PinwheelerIntern-1/SmartCar/Audio/AudioTable.docx

Sl.No. | Audio File Name | Text | Duration miiliseconds
1 | 001.mp3 | Move Aside ,please give me side.
2 | 002 | Battery Low, Please Charge
3 | 003 | Hello, How are you doing today.
4 | 004 | Car is going Forward
5 | 005 | Car is going Reverse
6 | 006 | Car is turning Left
7 | 007 | Car is turning Right
8 | 008 | Car is spinning left
9 | 009 | Car is spinning Right
10 | 010 | Welcome to the future | 2000
11 | 011 | Network Connected
12 | 012 | Network Disconnected
13 | 013 | Music-Jingle
14 | 014 | Music-Caravan
15 | 015 | Have You quit Smoking
16 | 016 | I know you are a bit tired! Let’s take a ride on electric bicycle.
17 | 017 | Welcome Mr. Albert Einstein and More…
18 | 018 | Have you quit Smoking and more…
19 | 019 | Please try this virtual reality goggles.
20 | 020 | Welcome Mr Albert Einstein , I know your past future anmd present. I even know your quirky habits.
21 | 021 | Battery Low- Female Adult
22 | 022 | Hi There ! How are you doing today –Female Adult Voice
23 | 023 | Take Your Order
24 | 024 | `Going To Bar
25 | 025 | Going To KItchen
26 | 026 | WiFi Connected
27 | 027 | Connecting To WiFi
28 | 028 | Please Move Aside
29 | 029 | Would You like to wear a powersuit ?
30 | 030 | You can use our bio-toilets.
31 | 031 | You might be hungry by now ? Let’s try something from Air-Fryer.
