PinwheelerIntern-1/SmartCar/Audio/WhatsApp Image 2021-11-11 at 7.47.23 AM.jpeg

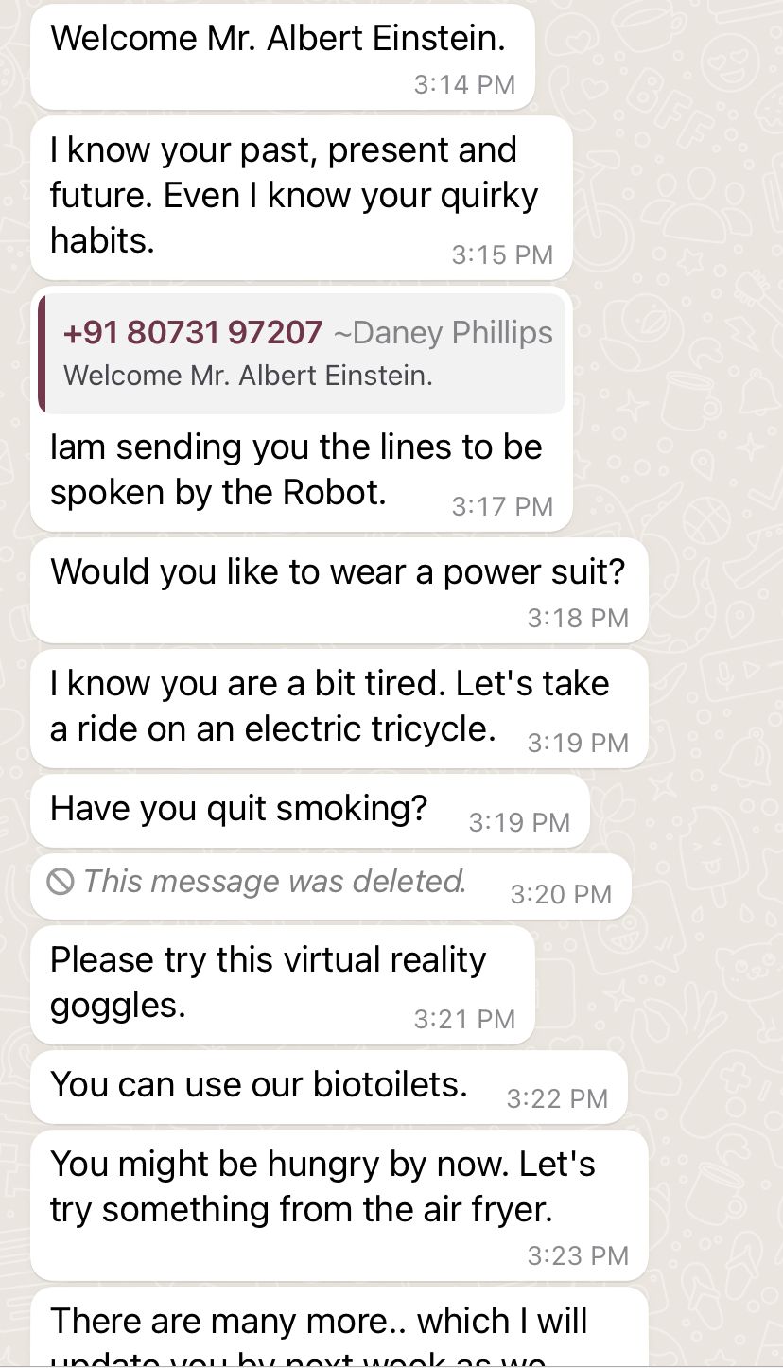
Audio/WhatsApp Image 2021-11-11 at 7.47.23 AM.jpeg
