PinwheelerIntern-1/SmartCar/PCBs/DIY-LM2596-Adjustable-Voltage-Swithching-Regulator.png

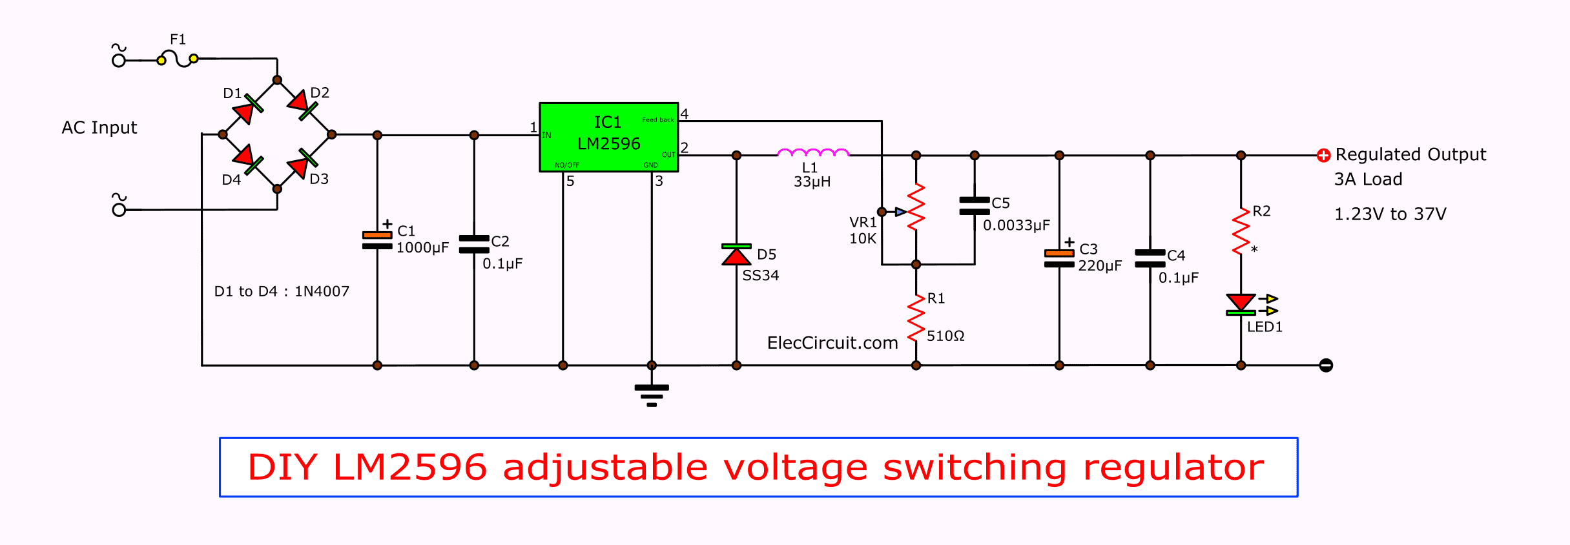
PCBs/DIY-LM2596-Adjustable-Voltage-Swithching-Regulator.png
