PinwheelerIntern-1/SmartCar/PCBs/5Obstacle.pdf

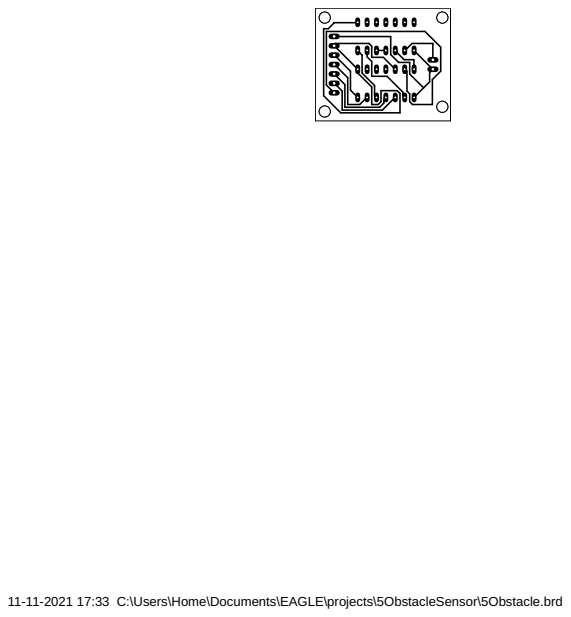
[picture p3: page 1]

11-11-2021 17:33 C:\Users\Home\Documents\EAGLE\projects\5ObstacleSensor\5Obstacle.brd
