PinwheelerIntern-1/SmartCar/PCBs/FutureBotNanoShield.brd

## EAGLE design PCBs/FutureBotNanoShield.brd (2021-12-03)

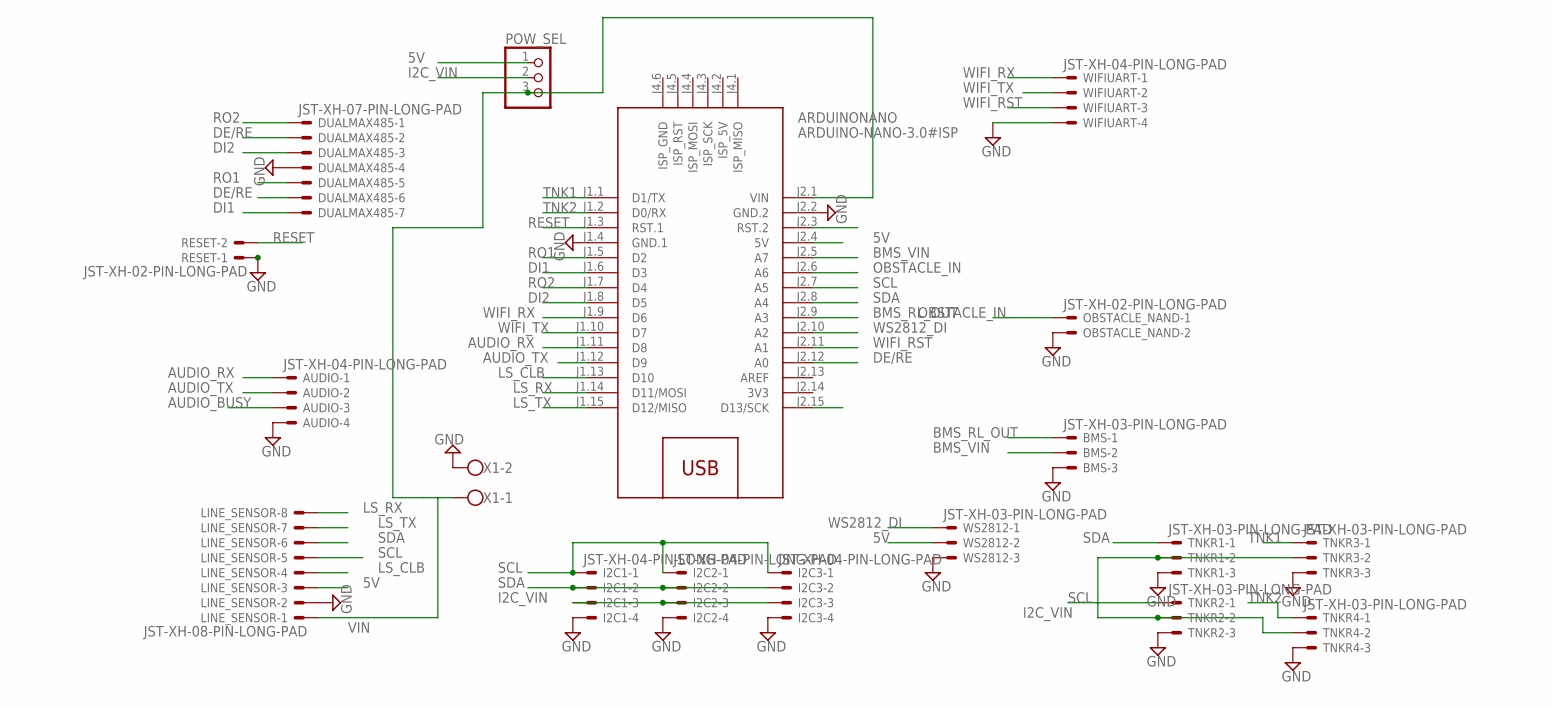
[picture p4: schematic FutureBotNanoShield.sch]

Parts:
ARDUINONANO: ARDUINO-NANO-3.0#ISP
AUDIO: JST-XH-04-PIN-LONG-PAD; JST-XH-04-PACKAGE-LONG-PAD
BMS: JST-XH-03-PIN-LONG-PAD; JST-XH-03-PACKAGE-LONG-PAD
DUALMAX485: JST-XH-07-PIN-LONG-PAD; JST-XH-07-PACKAGE-LONG-PAD
I2C1, I2C2, I2C3: JST-XH-04-PIN-LONG-PAD; JST-XH-04-PACKAGE-LONG-PAD
LINE_SENSOR: JST-XH-08-PIN-LONG-PAD; JST-XH-08-PACKAGE-LONG-PAD
OBSTACLE_NAND: JST-XH-02-PIN-LONG-PAD; JST-XH-02-PACKAGE-LONG-PAD
POW_SEL: PINHD-1X3; 1X03
RESET: JST-XH-02-PIN-LONG-PAD; JST-XH-02-PACKAGE-LONG-PAD
TNKR1, TNKR2, TNKR3, TNKR4: JST-XH-03-PIN-LONG-PAD; JST-XH-03-PACKAGE-LONG-PAD
WIFIUART: JST-XH-04-PIN-LONG-PAD; JST-XH-04-PACKAGE-LONG-PAD
WS2812: JST-XH-03-PIN-LONG-PAD; JST-XH-03-PACKAGE-LONG-PAD
X1: W237-102

Connections:
3V3: ARDUINONANO.J2.14 (3V3)
5V: ARDUINONANO.J2.4 (5V), LINE_SENSOR.3, POW_SEL.1, WS2812.2
AUDIO_BUSY: AUDIO.3
AUDIO_RX: ARDUINONANO.J1.11 (D8), AUDIO.1
AUDIO_TX: ARDUINONANO.J1.12 (D9), AUDIO.2
BMS_RL_OUT: ARDUINONANO.J2.9 (A3), BMS.1
BMS_VIN: ARDUINONANO.J2.5 (A7), BMS.2
DE/RE: ARDUINONANO.J2.12 (A0), DUALMAX485.2, DUALMAX485.6
DI1: ARDUINONANO.J1.6 (D3), DUALMAX485.7
DI2: ARDUINONANO.J1.8 (D5), DUALMAX485.3
GND: ARDUINONANO.J1.4 (GND.1), ARDUINONANO.J2.2 (GND.2), AUDIO.4, BMS.3, DUALMAX485.4, I2C1.4, I2C2.4, I2C3.4, LINE_SENSOR.2, OBSTACLE_NAND.2, RESET.1, TNKR1.3, TNKR2.3, TNKR3.3, TNKR4.3, WIFIUART.4, WS2812.3, X1.2
I2C_VIN: I2C1.3, I2C2.3, I2C3.3, POW_SEL.2, TNKR1.2, TNKR2.2, TNKR3.2, TNKR4.2
LS_CLB: ARDUINONANO.J1.13 (D10), LINE_SENSOR.4
LS_RX: ARDUINONANO.J1.14 (D11/MOSI), LINE_SENSOR.8
LS_TX: ARDUINONANO.J1.15 (D12/MISO), LINE_SENSOR.7
OBSTACLE_IN: ARDUINONANO.J2.6 (A6), OBSTACLE_NAND.1
RESET: ARDUINONANO.J1.3 (RST.1), RESET.2
RO1: ARDUINONANO.J1.5 (D2), DUALMAX485.5
RO2: ARDUINONANO.J1.7 (D4), DUALMAX485.1
SCL: ARDUINONANO.J2.7 (A5), I2C1.1, I2C2.1, I2C3.1, LINE_SENSOR.5, TNKR2.1
SDA: ARDUINONANO.J2.8 (A4), I2C1.2, I2C2.2, I2C3.2, LINE_SENSOR.6, TNKR1.1
TNK1: ARDUINONANO.J1.1 (D1/TX), TNKR3.1
TNK2: ARDUINONANO.J1.2 (D0/RX), TNKR4.1
VIN: ARDUINONANO.J2.1 (VIN), LINE_SENSOR.1, POW_SEL.3, X1.1
WIFI_RST: ARDUINONANO.J2.11 (A1), WIFIUART.3
WIFI_RX: ARDUINONANO.J1.9 (D6), WIFIUART.1
WIFI_TX: ARDUINONANO.J1.10 (D7), WIFIUART.2
WS2812_DI: ARDUINONANO.J2.10 (A2), WS2812.1

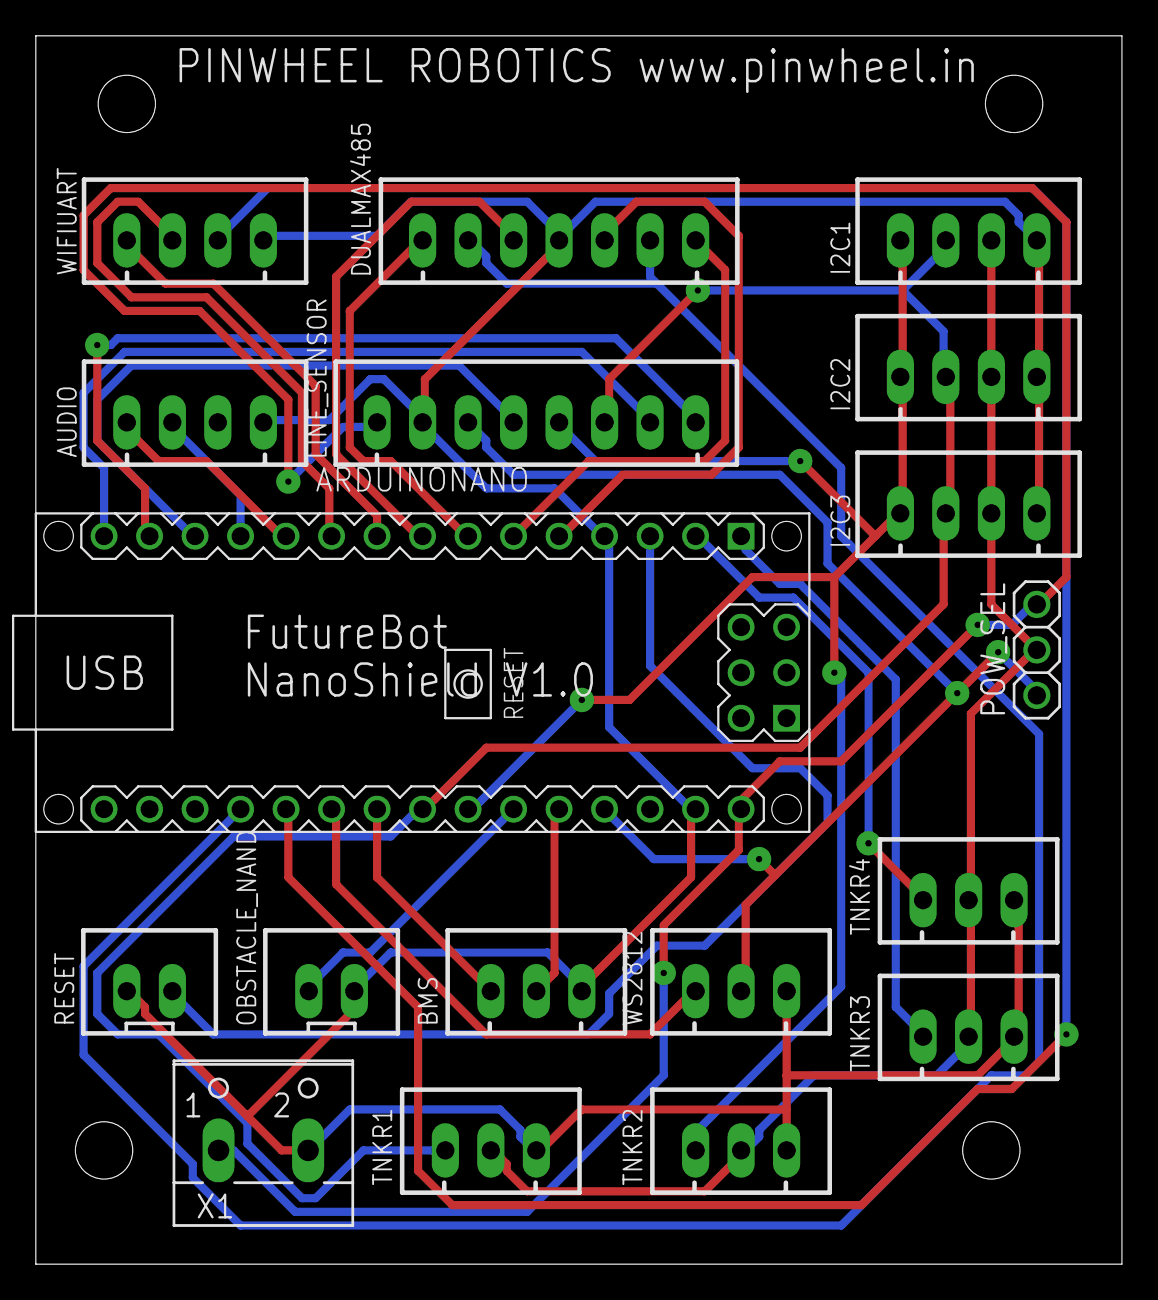
[picture p5: board FutureBotNanoShield.brd from above]

Board: 2 copper layers, 60.6 x 68.6 mm, 18 parts (0 on the bottom side), 26 nets.
