PinwheelerIntern-1/SmartCar/PCBs/5ObstacleNAND.brd

## EAGLE design PCBs/5ObstacleNAND.brd (2021-12-01)

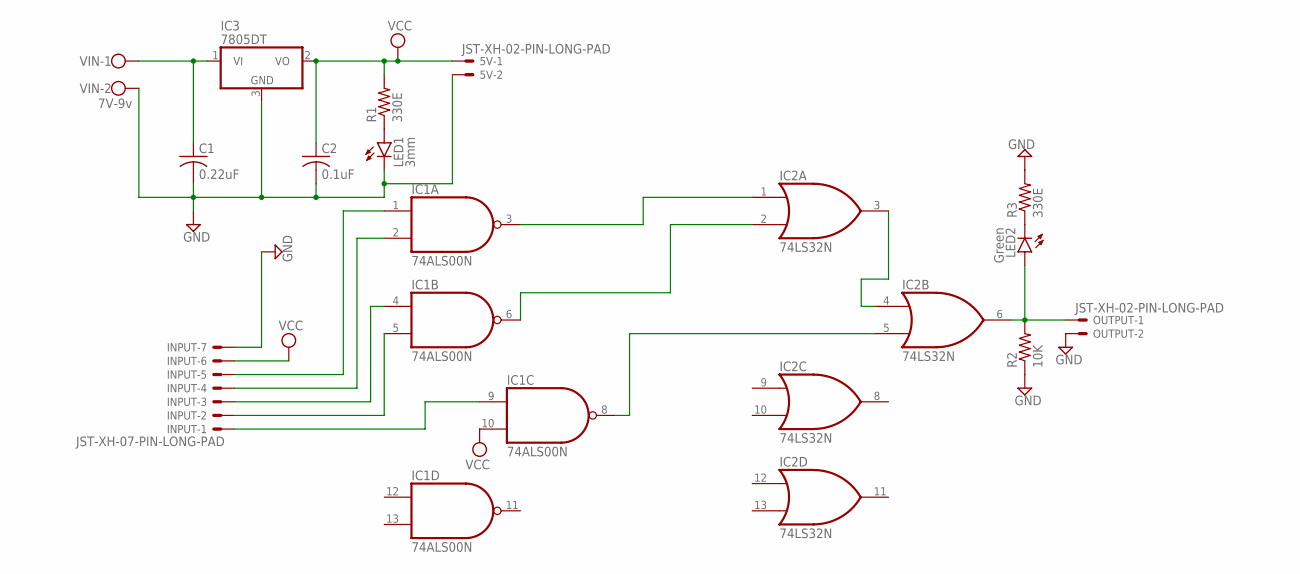
[picture p6: schematic 5ObstacleNAND.sch]

Parts:
5V: JST-XH-02-PIN-LONG-PAD; JST-XH-02-PACKAGE-LONG-PAD
C1: 0.22uF; C0805
C2: 0.1uF; C0805
IC1: 74ALS00N; DIL14
IC2: 74LS32N; DIL14
IC3: 7805DT; TO252
INPUT: JST-XH-07-PIN-LONG-PAD; JST-XH-07-PACKAGE-LONG-PAD
LED1: 3mm; SML0805
LED2: Green; SML0805
OUTPUT: JST-XH-02-PIN-LONG-PAD; JST-XH-02-PACKAGE-LONG-PAD
R1, R3: 330E; R0805
R2: 10K; R0805
VIN: 7V-9v; W237-102

Connections:
GND: 5V.2, C1.2, C2.2, IC1.7 (GND), IC2.7 (GND), IC3.3 (GND), INPUT.7, LED1.C, OUTPUT.2, R2.1, R3.2, VIN.2
unnamed: IC1.1 (I0), INPUT.5
unnamed: IC1.2 (I1), INPUT.4
unnamed: IC1.4 (I0), INPUT.3
unnamed: IC1.5 (I1), INPUT.2
unnamed: IC1.9 (I0), INPUT.1
unnamed: IC1.3 (O), IC2.1 (I0)
unnamed: IC1.6 (O), IC2.2 (I1)
unnamed: IC2.3 (O), IC2.4 (I0)
unnamed: IC1.8 (O), IC2.5 (I1)
unnamed: IC2.6 (O), LED2.A, OUTPUT.1, R2.2
unnamed: LED2.C, R3.1
unnamed: LED1.A, R1.1
unnamed: C1.1, IC3.1 (VI), VIN.1
VCC: 5V.1, C2.1, IC1.10 (I1), IC1.14 (VCC), IC2.14 (VCC), IC3.2 (VO), INPUT.6, R1.2

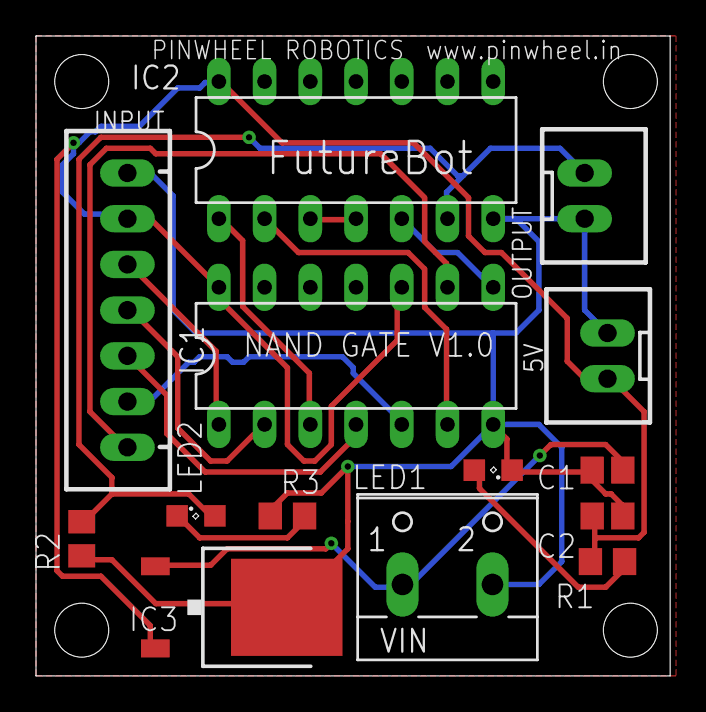
[picture p7: board 5ObstacleNAND.brd from above]

Board: 2 copper layers, 35.2 x 35.6 mm, 14 parts (0 on the bottom side), 15 nets.
