PinwheelerIntern-1/SmartCar/PCBs/DFPLayerAudio.brd

## EAGLE design PCBs/DFPLayerAudio.brd (2021-12-01)

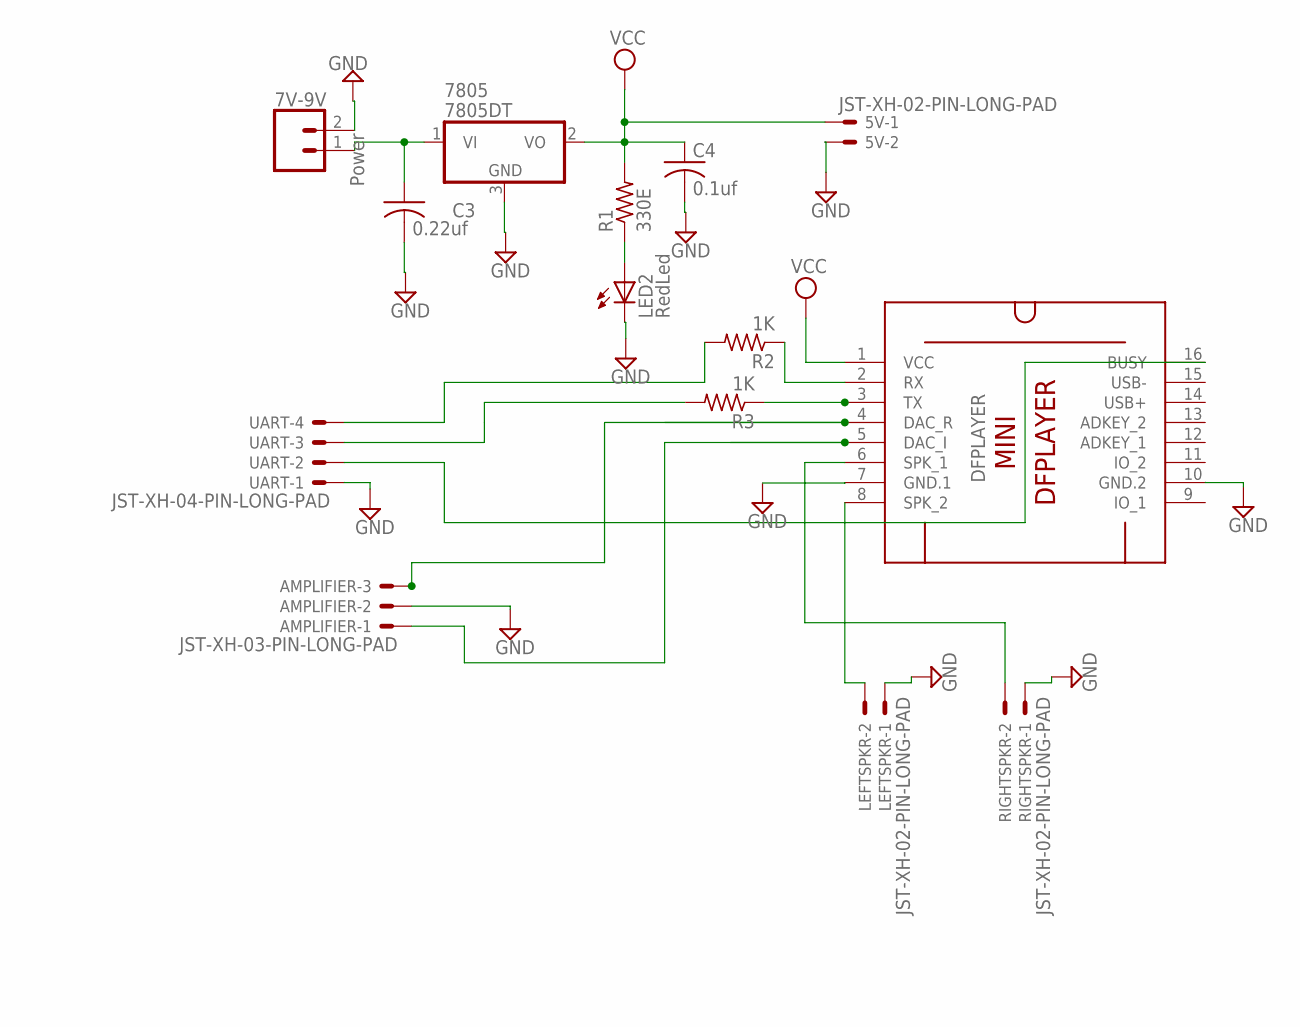
[picture p8: schematic DFPLayerAudio.sch]

Parts:
5V: JST-XH-02-PIN-LONG-PAD; JST-XH-02-PACKAGE-LONG-PAD
7V-9V: Power; SCREWTERMINAL-5MM-2
7805: 7805DT; TO252
AMPLIFIER: JST-XH-03-PIN-LONG-PAD; JST-XH-03-PACKAGE-LONG-PAD
C3: 0.22uf; C0805K
C4: 0.1uf; C0805K
DFPLAYER: DFPLAYER-MINI-MODULE
LED2: RedLed; CHIPLED_0805
LEFTSPKR: JST-XH-02-PIN-LONG-PAD; JST-XH-02-PACKAGE-LONG-PAD
R1: 330E; M0805
R2, R3: 1K; M0805
RIGHTSPKR: JST-XH-02-PIN-LONG-PAD; JST-XH-02-PACKAGE-LONG-PAD
UART: JST-XH-04-PIN-LONG-PAD; JST-XH-04-PACKAGE-LONG-PAD

Connections:
GND: 5V.2, 7V-9V.2, 7805.3 (GND), AMPLIFIER.2, C3.2, C4.2, DFPLAYER.7 (GND.1), DFPLAYER.10 (GND.2), LED2.C, LEFTSPKR.1, RIGHTSPKR.1, UART.1
unnamed: AMPLIFIER.3, DFPLAYER.4 (DAC_R)
unnamed: 7V-9V.1, 7805.1 (VI), C3.1
unnamed: DFPLAYER.3 (TX), R3.1
unnamed: DFPLAYER.2 (RX), R2.1
unnamed: DFPLAYER.16 (BUSY), UART.2
unnamed: R3.2, UART.3
unnamed: R2.2, UART.4
unnamed: DFPLAYER.8 (SPK_2), LEFTSPKR.2
unnamed: AMPLIFIER.1, DFPLAYER.5 (DAC_I)
unnamed: LED2.A, R1.1
unnamed: DFPLAYER.6 (SPK_1), RIGHTSPKR.2
VCC: 5V.1, 7805.2 (VO), C4.1, DFPLAYER.1 (VCC), R1.2

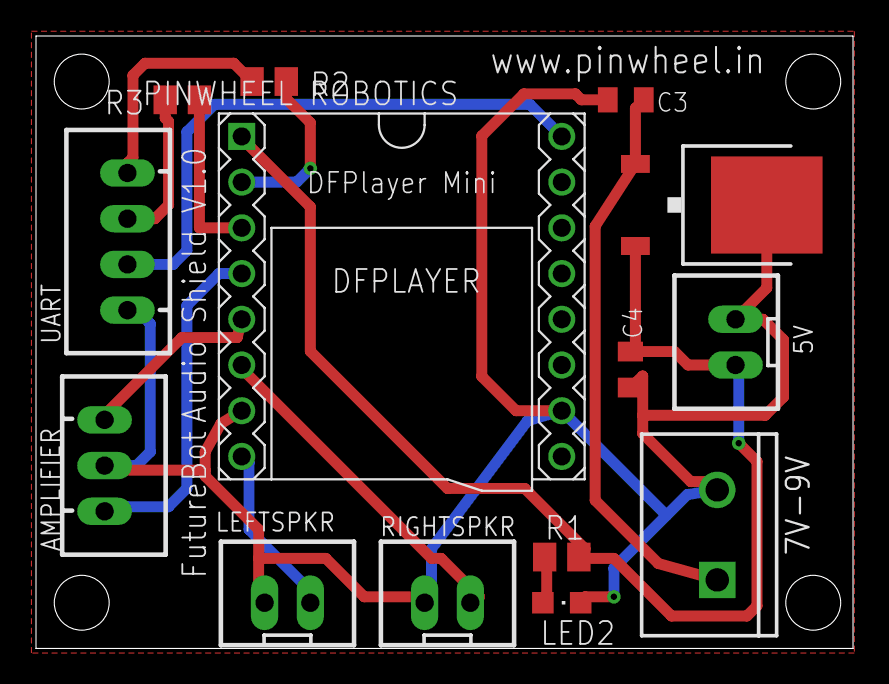
[picture p9: board DFPLayerAudio.brd from above]

Board: 2 copper layers, 45.4 x 34.0 mm, 14 parts (0 on the bottom side), 13 nets.
