PinwheelerIntern-1/SmartCar/PCBs/DualMax485.brd

## EAGLE design PCBs/DualMax485.brd (2021-12-01)

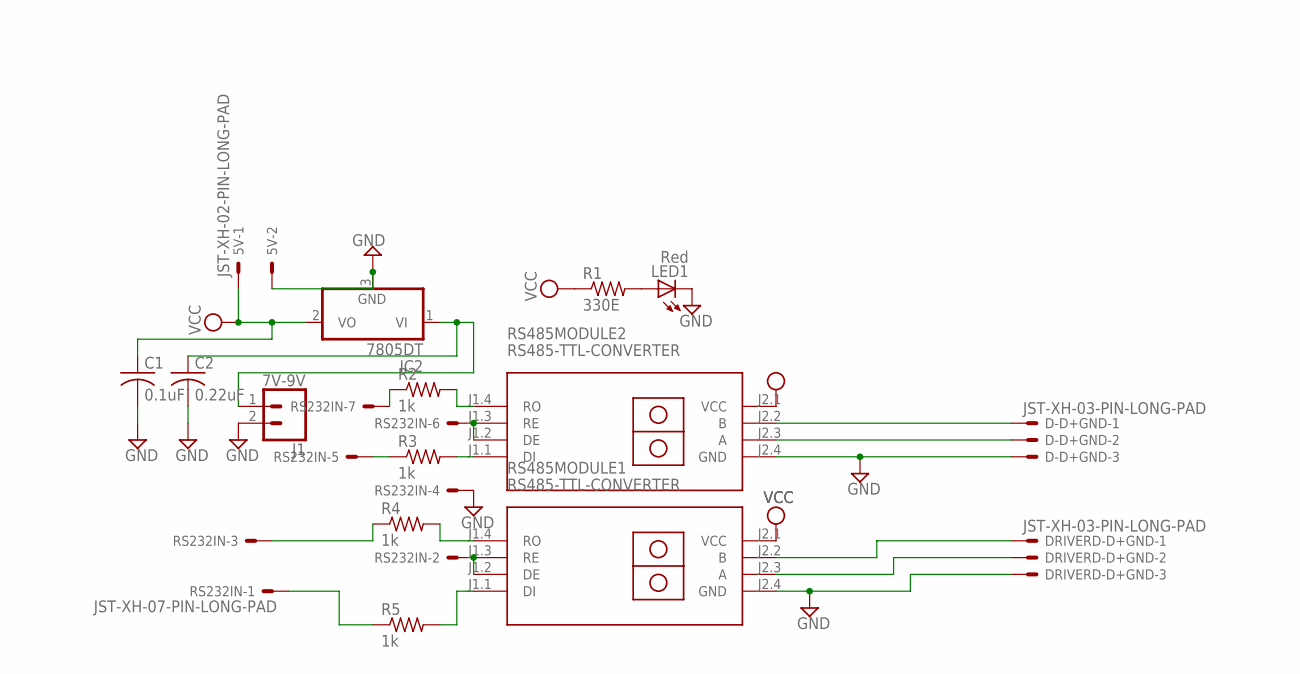
[picture p10: schematic DualMax485.sch]

Parts:
5V: JST-XH-02-PIN-LONG-PAD; JST-XH-02-PACKAGE-LONG-PAD
C1: 0.1uF; C0805
C2: 0.22uF; C0805
D-D+GND: JST-XH-03-PIN-LONG-PAD; JST-XH-03-PACKAGE-LONG-PAD
DRIVERD-D+GND: JST-XH-03-PIN-LONG-PAD; JST-XH-03-PACKAGE-LONG-PAD
IC2: 7805DT; TO252
J1: 7V-9V; SCREWTERMINAL-5MM-2
LED1: Red; CHIPLED_0805
R1: 330E; M0805
R2, R3, R4, R5: 1k; M0805
RS232IN: JST-XH-07-PIN-LONG-PAD; JST-XH-07-PACKAGE-LONG-PAD
RS485MODULE1, RS485MODULE2: RS485-TTL-CONVERTER

Connections:
GND: 5V.2, C1.2, C2.2, D-D+GND.3, DRIVERD-D+GND.3, IC2.3 (GND), J1.2, LED1.C, RS232IN.4, RS485MODULE1.J2.4 (GND), RS485MODULE2.J2.4 (GND)
unnamed: RS232IN.6, RS485MODULE2.J1.2 (DE), RS485MODULE2.J1.3 (RE)
unnamed: R3.2, RS485MODULE2.J1.1 (DI)
unnamed: R2.2, RS485MODULE2.J1.4 (RO)
unnamed: D-D+GND.1, RS485MODULE2.J2.2 (B)
unnamed: R3.1, RS232IN.5
unnamed: D-D+GND.2, RS485MODULE2.J2.3 (A)
unnamed: RS232IN.2, RS485MODULE1.J1.2 (DE), RS485MODULE1.J1.3 (RE)
unnamed: R5.1, RS232IN.1
unnamed: LED1.A, R1.2
unnamed: R4.1, RS232IN.3
unnamed: R2.1, RS232IN.7
unnamed: DRIVERD-D+GND.1, RS485MODULE1.J2.2 (B)
unnamed: DRIVERD-D+GND.2, RS485MODULE1.J2.3 (A)
unnamed: R4.2, RS485MODULE1.J1.4 (RO)
unnamed: R5.2, RS485MODULE1.J1.1 (DI)
unnamed: C2.1, IC2.1 (VI), J1.1
VCC: 5V.1, C1.1, IC2.2 (VO), R1.1, RS485MODULE1.J2.1 (VCC), RS485MODULE2.J2.1 (VCC)

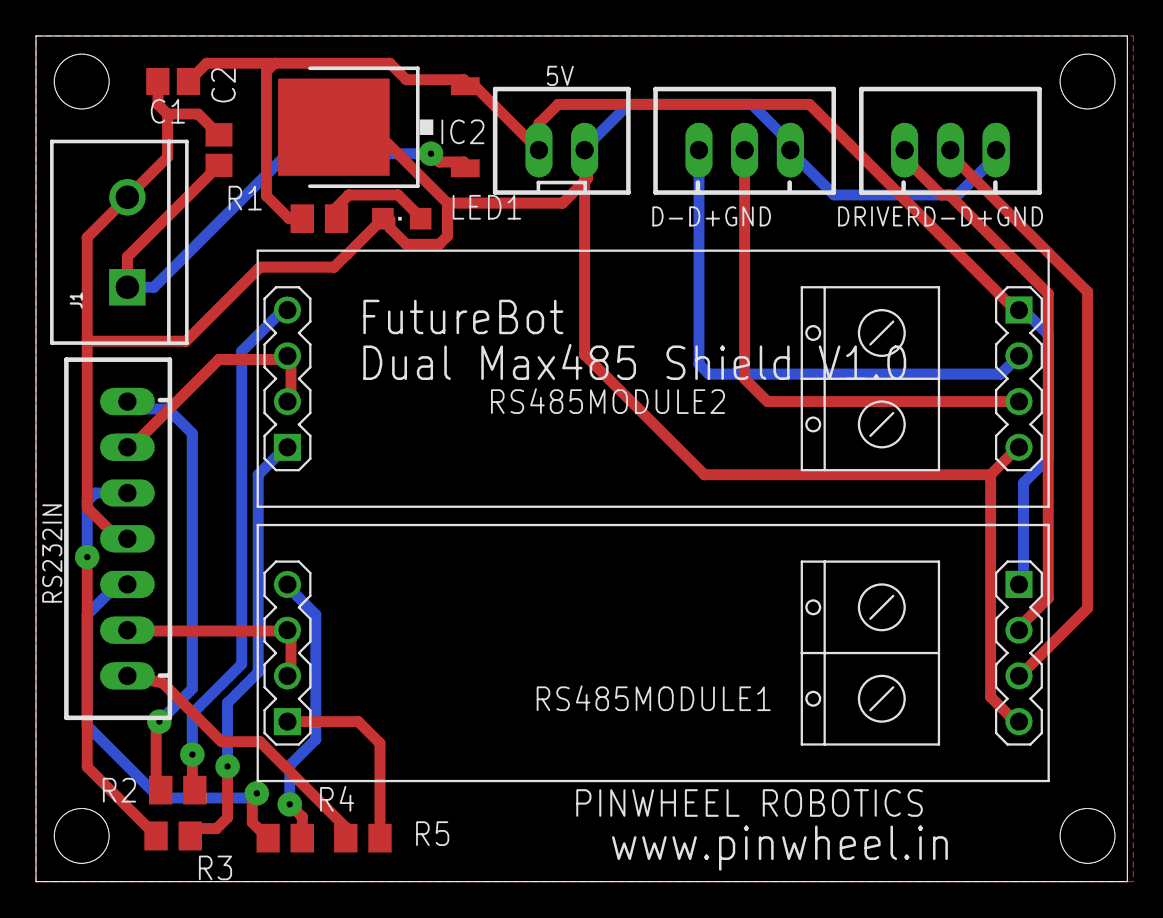
[picture p11: board DualMax485.brd from above]

Board: 2 copper layers, 60.6 x 47.0 mm, 16 parts (0 on the bottom side), 18 nets.
