PinwheelerIntern-1/SmartCar/PCBs/NodeMCU.brd

## EAGLE design PCBs/NodeMCU.brd (2021-12-01)

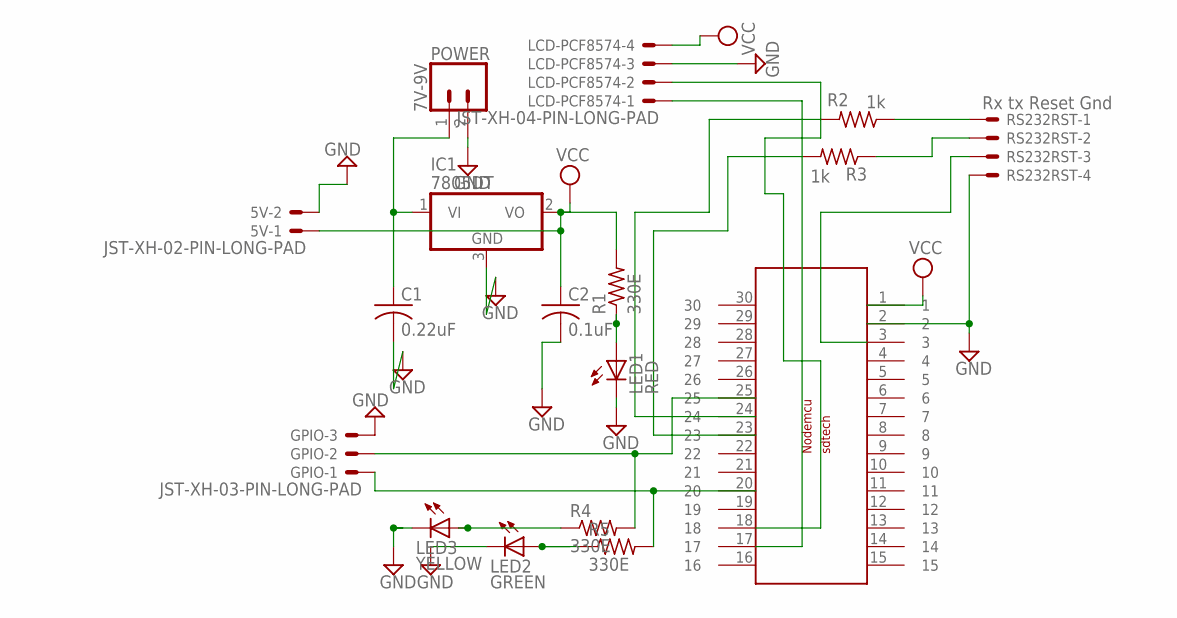
[picture p12: schematic NodeMCU.sch]

Parts:
5V: JST-XH-02-PIN-LONG-PAD; JST-XH-02-PACKAGE-LONG-PAD
C1: 0.22uF; C0805K
C2: 0.1uF; C0805K
GPIO: JST-XH-03-PIN-LONG-PAD; JST-XH-03-PACKAGE-LONG-PAD
IC1: 7805DT; TO252
LCD-PCF8574: JST-XH-04-PIN-LONG-PAD; JST-XH-04-PACKAGE-LONG-PAD
LED1: RED; CHIPLED_0805
LED2: GREEN; CHIPLED_0805
LED3: YELLOW; CHIPLED_0805
POWER: 7V-9V; SCREWTERMINAL-5MM-2
R1, R4, R5: 330E; M0805
R2, R3: 1k; M0805
RS232RST: Rx tx Reset Gnd; JST-XH-04-PACKAGE-LONG-PAD
U$2: NodeMCU-ESP12E; NODEMCUESP8266

Connections:
GND: 5V.2, C1.2, C2.2, GPIO.3, IC1.3 (GND), LCD-PCF8574.3, LED1.C, LED2.C, LED3.C, POWER.2, RS232RST.4, U$2.2
unnamed: LED1.A, R1.1
unnamed: LCD-PCF8574.2, U$2.18
unnamed: LED3.A, R4.1
unnamed: LED2.A, R5.1
unnamed: R2.1, RS232RST.1
unnamed: R2.2, U$2.24
unnamed: LCD-PCF8574.1, U$2.17
unnamed: R3.2, U$2.23
unnamed: C1.1, IC1.1 (VI), POWER.1
unnamed: R3.1, RS232RST.2
unnamed: RS232RST.3, U$2.3
unnamed: GPIO.2, R4.2, U$2.25
unnamed: GPIO.1, R5.2, U$2.20
VCC: 5V.1, C2.1, IC1.2 (VO), LCD-PCF8574.4, R1.2, U$2.1

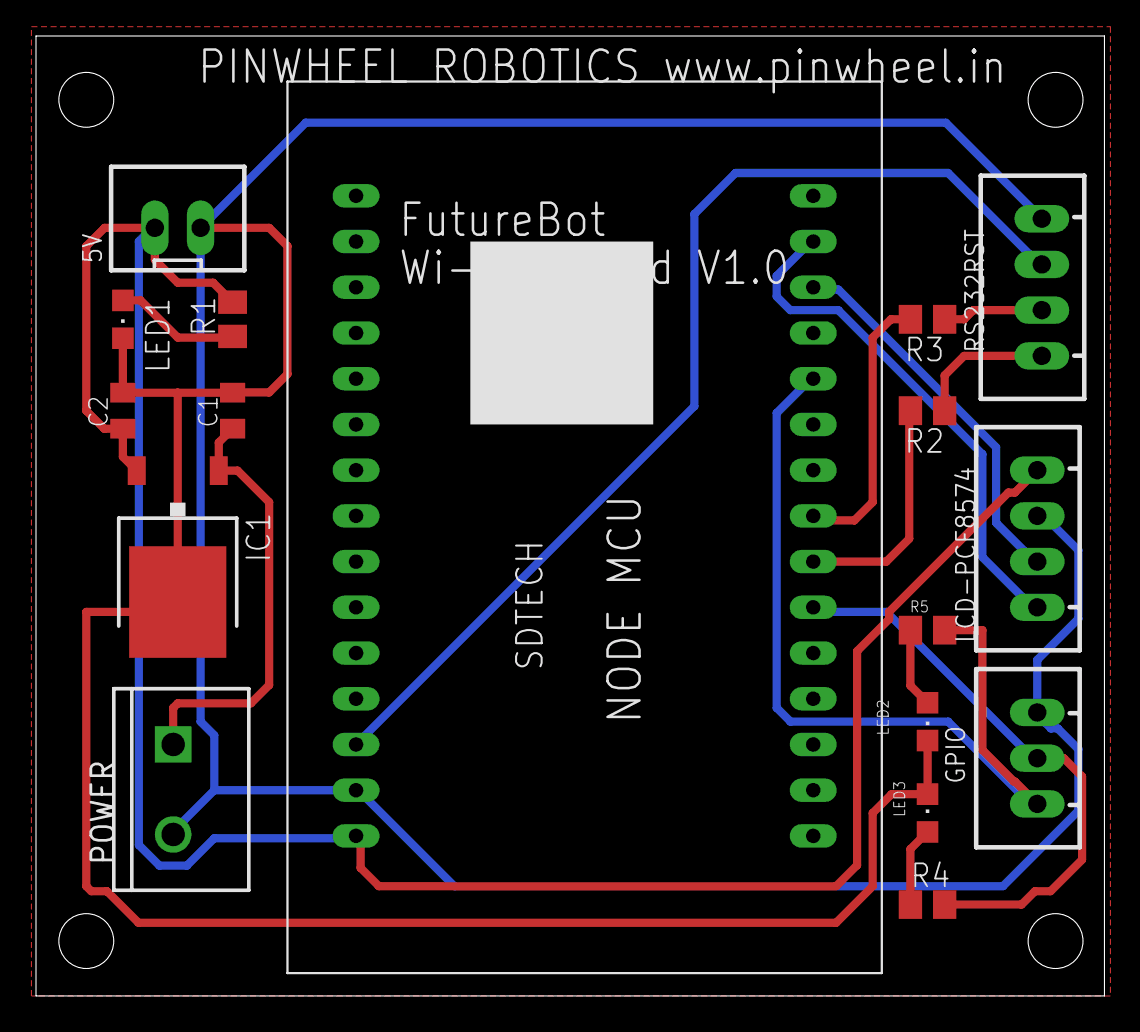
[picture p13: board NodeMCU.brd from above]

Board: 2 copper layers, 59.4 x 53.3 mm, 17 parts (0 on the bottom side), 15 nets.
