PinwheelerIntern-1/SmartCar/PCBs/BMSBoard.brd

## EAGLE design PCBs/BMSBoard.brd (2021-11-29)

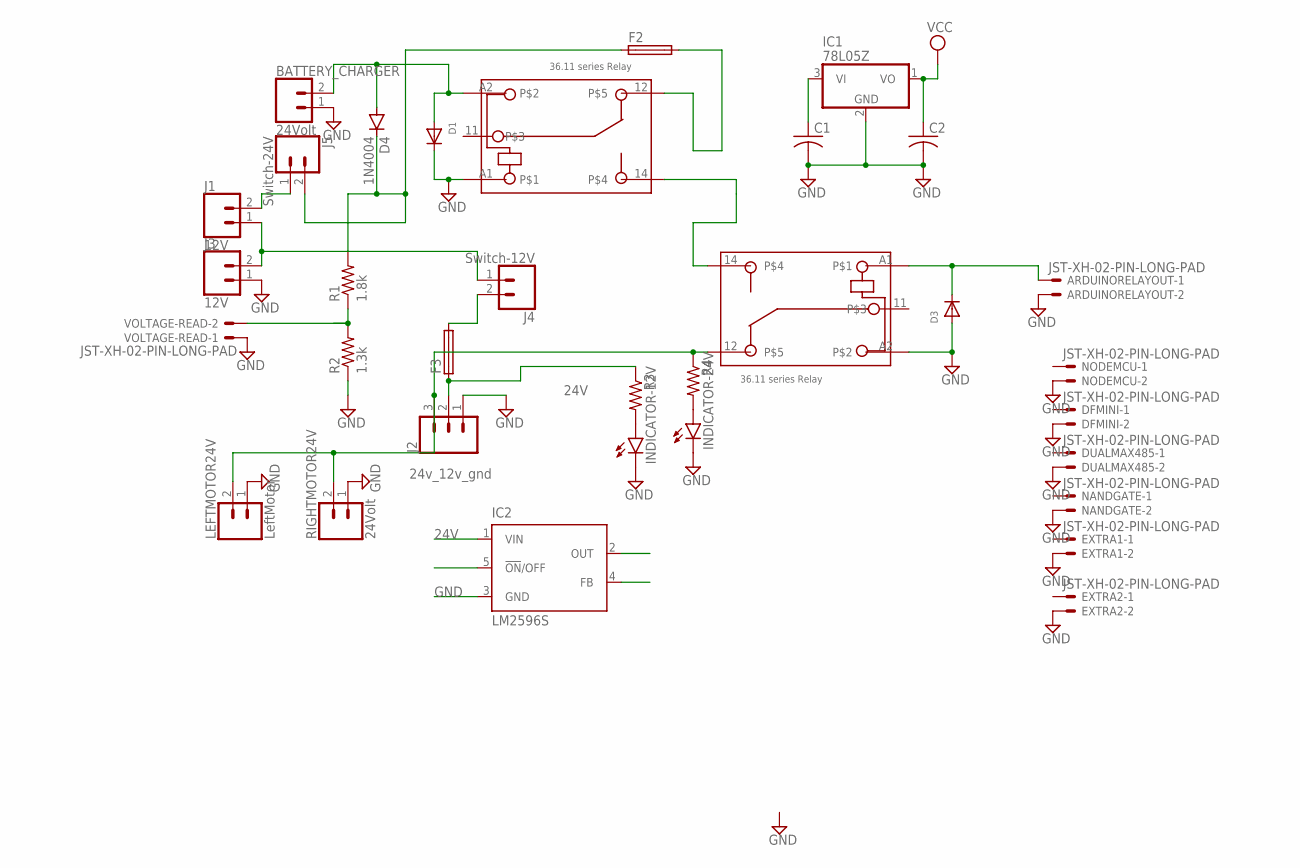
[picture p14: schematic BMSBoard.sch]

Parts:
ARDUINORELAYOUT: JST-XH-02-PIN-LONG-PAD; JST-XH-02-PACKAGE-LONG-PAD
BATTERY_CHARGER: 24Volt; SCREWTERMINAL-3.5MM-2
BMSRELAY: 36.11
C1, C2: C-US025-024X044; C025-024X044
CHARGERRELAY: 36.11
D1, D3: DIODEDO-1N4148; DO-1N4148
D4: 1N4004; DO41-10
DFMINI: JST-XH-02-PIN-LONG-PAD; JST-XH-02-PACKAGE-LONG-PAD
DUALMAX485: JST-XH-02-PIN-LONG-PAD; JST-XH-02-PACKAGE-LONG-PAD
EXTRA1, EXTRA2: JST-XH-02-PIN-LONG-PAD; JST-XH-02-PACKAGE-LONG-PAD
F2, F3: 19560
IC1: 78L05Z; TO92
IC2: LM2596S; TO263-5
INDICATOR-12V, INDICATOR-24V: LED; SMARTLED-TTW
J1, J3: 12V; SCREWTERMINAL-3.5MM-2
J2: 24v_12v_gnd; SCREWTERMINAL-5MM-3
J4: Switch-12V; SCREWTERMINAL-3.5MM-2
J5: Switch-24V; SCREWTERMINAL-3.5MM-2
LEFTMOTOR24V: LeftMotor; SCREWTERMINAL-3.5MM-2
NANDGATE: JST-XH-02-PIN-LONG-PAD; JST-XH-02-PACKAGE-LONG-PAD
NODEMCU: JST-XH-02-PIN-LONG-PAD; JST-XH-02-PACKAGE-LONG-PAD
R1: 1.8k; 0204/7
R2: 1.3k; 0204/7
R3, R4: R-US_0204/2V; 0204V
RIGHTMOTOR24V: 24Volt; SCREWTERMINAL-3.5MM-2
VOLTAGE-READ: JST-XH-02-PIN-LONG-PAD; JST-XH-02-PACKAGE-LONG-PAD

Connections:
24V: F3.1, IC2.1 (VIN), J2.2, R3.1
GND: ARDUINORELAYOUT.2, BATTERY_CHARGER.1, BMSRELAY.A2, C1.2, C2.2, CHARGERRELAY.A1, D1.C, D3.A, DFMINI.2, DUALMAX485.2, EXTRA1.2, EXTRA2.2, IC1.2 (GND), IC2.3 (GND), INDICATOR-12V.C@1 (C), INDICATOR-24V.C@1 (C), J2.1, J3.1, LEFTMOTOR24V.1, NANDGATE.2, NODEMCU.2, R2.1, RIGHTMOTOR24V.1, VOLTAGE-READ.1
unnamed: R1.1, R2.2, VOLTAGE-READ.2
unnamed: BATTERY_CHARGER.2, CHARGERRELAY.A2, D1.A, D4.A
unnamed: CHARGERRELAY.12, F2.2
unnamed: ARDUINORELAYOUT.1, BMSRELAY.A1, D3.C
unnamed: D4.C, F2.1, J5.2, R1.2
unnamed: BMSRELAY.14, CHARGERRELAY.14
unnamed: BMSRELAY.12, J2.3, LEFTMOTOR24V.2, R4.1, RIGHTMOTOR24V.2
unnamed: J1.1, J3.2, J4.1
unnamed: C1.1, IC1.3 (VI)
unnamed: J1.2, J5.1
unnamed: F3.2, J4.2
unnamed: INDICATOR-24V.A@1 (A), R4.2
unnamed: INDICATOR-12V.A@1 (A), R3.2
VCC: C2.1, IC1.1 (VO)

Board: 2 copper layers, 33 parts (0 on the bottom side), 16 nets, no tracks yet.
