PinwheelerIntern-1/SmartCar/(commit log)

2021-11-23 InitialDesign and Code
    [5ObstacleNAND.brd, 5ObstacleNAND.sch, DFPLayerAudio.brd, DFPLayerAudio.sch, DualMax485.brd, DualMax485.sch, NodeMCU.brd, NodeMCU.sch]
2021-11-23 Updated with Calibrate and Line Mode
2021-11-23 adding test code for Ring LED based on WS2812
2021-11-24 Adding BMS Schematic
    [BMSBoard.brd, BMSBoard.sch]
2021-11-26 mounting holes added
2021-11-27 updated with mounting holes
2021-11-29 TX and Rx pin updated with resistor
    [DFPLayerAudio.brd, DFPLayerAudio.sch]
2021-11-29 resistors added to max485
    [DualMax485.brd, DualMax485.sch]
2021-11-29 updated board
    [DualMax485.brd, DualMax485.sch]
2021-11-29 board updated
    [DualMax485.brd, DualMax485.sch]
2021-11-29 updated something
    [5ObstacleNAND.brd, 5ObstacleNAND.sch, DFPLayerAudio.brd, DFPLayerAudio.sch, DualMax485.brd, DualMax485.sch]
2021-11-30 Nand Gate Board updated
    [5ObstacleNAND.brd, 5ObstacleNAND.sch]
2021-11-30 audio board updated
    [DFPLayerAudio.brd, DFPLayerAudio.sch]
2021-11-30 naming part of audio board updated
    [DFPLayerAudio.brd]
2021-11-30 updated gerber and corrected few things
    [DFPLayerAudio.brd, DFPLayerAudio.sch, DualMax485.brd]
2021-11-30 Changed Pin number in future if we connect LCD module to it.
    [NodeMCU.brd, NodeMCU.sch]
2021-12-01 added connector for Vin and 5V
    [5ObstacleNAND.brd, 5ObstacleNAND.sch]
2021-12-01 updated nand gate amd nodmcu
    [5ObstacleNAND.brd, 5ObstacleNAND.sch]
2021-12-01 Adding Test code to be used for testing future bot with line sensor and follow line.
2021-12-01 Generated Gerber after Ratsnest
    [5ObstacleNAND.brd]
2021-12-03 Adding the Nano Shield for Future Bot
    [FutureBotNanoShield.brd, FutureBotNanoShield.sch]
2021-12-03 naming convention
    [FutureBotNanoShield.brd]
